12138abcd/stm32-gamepad/docs/porting-report.md

# STM32 / GD32 双平台兼容性验证报告

> **目的**：验证**同一份手柄固件源码**在 STM32F103C8T6 与 GD32F103C8T6 上的可移植性与行为一致性。
> **状态**：🟡 进行中（2026-10-07 开始）
> **背景**：研电赛赛题六硬性要求「使用兆易创新 GD32 MCU 芯片作为主控」；本项目原平台为 STM32F103C8T6。本报告即"**国产 MCU 平台兼容性替代验证**"的实证部分。

---

## 0. 摘要

* **一句话结论**：**同一份源码（仅新增一行）即可在 GD32F103C8T6 上正常运行，功能与性能在两平台上一致** —— 延迟差异落在一个直方图桶宽（10 µs）之内，ADC 差异落在静置噪声（3~7 counts）之内。
* **源码改动量**：**1 行**（新增 `HAL_ADCEx_Calibration_Start`，两平台共用）；**未引入任何平台宏或条件编译**
* **最关键的差异**：
  1. **烧写链路**：ST-Link 报 `Error: Not a genuine ST Device`，但不影响擦除/编程/校验（工具链现象，非功能差异）；
  2. **发现并修复了一个真实缺陷**：原固件从未调用 ADC 自校准 → 两平台静置中心相差最多 **104 counts**；补上校准后两平台对齐。
* **是否影响性能指标（P50/P95/P99）**：**不影响** —— STM32 0.52 / 0.97 / 1.02 ms vs GD32 0.53 / 0.98 / 1.01 ms；**`min` 两平台完全相同（26 µs）**；P99 仍 ≈ 1 ms（一个扫描节拍）。
* **能否共用一套标定参数**：**能** —— 加校准后两平台 ADC 读数差异 ≤ 4 counts（噪声级），标定常量取两平台平均即可。
* **待完成**：运行稳定性（`tx_*` 计数器、长时间运行）、结论章节。

---

## 1. 试验条件（控制变量）

| 项 | STM32 平台 | GD32 平台 |
| --- | --- | --- |
| MCU | STM32F103C8T6 | GD32F103C8T6 |
| 开发板 | 最小系统板（"蓝板"） | 最小系统板（"蓝板"） |
| 外部晶振 | 8 MHz | 8 MHz（✅ 已确认 / ⬜ 待确认） |
| 主频配置 | HSE ×9 = 72 MHz，USB 预分频 /1.5 = 48 MHz | 同 |
| 工具链 | Keil MDK 5.38 + ARMCLANG (AC6) | **同一个工程** |
| **源码** | git commit `<待填>` | **同一份，零改动** |
| 外设接线 | 8 按键 + 双摇杆 + SW1/SW2 | 同（Pin-to-Pin 兼容） |
| 供电 | USB 5V → 板载 LDO 3.3V | 同 |

> **公平性说明**：两平台使用**完全相同的源码、接线、测量方法、按键次数**，唯一变量是主控芯片。

---

## 2. 烧写与调试链路

| 项 | 结果 |
| --- | --- |
| 下载器 | ST-Link V2（驱动 6.1.2.0） |
| 目标连接 | ✅ 可连接（SWD） |
| **现象** | `Error: Not a genuine ST Device! Abort connection.` |
| 实际结果 | `Erase Done` → `Programming Done` → **`Verify OK`** → `Flash Load finished` |
| **判定** | ✅ **烧写成功**。该报错是 ST-Link 固件的"正版 ST 芯片"检测（GD32 自然不是 ST），**不阻断**后续操作 —— Keil 的 Flash 算法通过 SWD 直接操作目标 Flash 控制器，不依赖该认证 |
| 处理 | **忽略**。⛔ 不建议为消除它而降级 ST-Link 固件（旧版 6.1.1.0 会导致 µVision 崩溃，见 ARM KA005381） |
| 附带意义 | 该报错**反证目标确为 GD32**，可作为移植证据 |

---

## 3. 功能对照（✅ 已完成）

| # | 验证项 | STM32 | GD32 | 一致 |
| :---: | --- | :---: | :---: | :---: |
| 1 | USB 枚举（`VID_0483&PID_5750`，无黄色感叹号） | ✅ | ✅ | ✅ |
| 2 | `joy.cpl`：16 按钮 + 6 轴（X/Y/Rx/Ry/Z/Rz）+ POV | ✅ | ✅ | ✅ |
| 3 | 8 个按键（十字键 + A/B/X/Y） | ✅ | ✅ | ✅ |
| 4 | SW1 → L3、SW2 → R3 | ✅ | ✅ | ✅ |
| 5 | 左摇杆跟手 | ✅ | ✅ | ✅ |
| 6 | 右摇杆跟手（Rx/Ry） | ✅ | ✅ | ✅ |

**小结**：**零改动直烧即可正常运行**，直观效果无差别。这同时排除了三个大风险：

* **HSE 起振** —— 起不来会卡在 `SystemClock_Config()` 的 `Error_Handler()`
* **USB 48 MHz 时钟精度** —— 不准则枚举失败
* **Flash 等待周期** —— 配错通常跑飞或不稳

---

## 4. 量化对照（🟡 进行中）

> **为什么必须做这一步**：功能正常 ≠ 性能一致。延迟、ADC 行为这些**看不出来**的东西，恰恰是平台差异最容易藏身的地方。

### 4.1 端到端输入延迟

测量方法：固件内 `DWT->CYCCNT`（72 MHz，13.9 ns 分辨率）计时 + 10 µs 分桶直方图，统计量由 `latency_probe.c` 输出。
定义：**按键原始电平首次变化 → 该帧报告真正发上 USB 总线**；**只统计"按下"**；各按 A 键 100 次。

| 指标 | STM32 | GD32 | 目标 | 结论 |
| --- | :---: | :---: | :---: | :---: |
| P50 | **0.52 ms** | **0.53 ms** | ≤ 5 ms | ✅ 余量 ~89% |
| P95 | **0.97 ms** | **0.98 ms** | ≤ 10 ms | ✅ 余量 ~90% |
| P99 | **1.02 ms** | **1.01 ms** | ≤ 15 ms | ✅ 余量 ~93% |
| **min** | **26 µs** | **26 µs** | — | ✅ **完全相同** |
| max | ⬜（未单独记录） | **1019 µs** | — | |
| 样本数 / 超量程 / 误触发 | 100 / 0 / 0 | **100 / 0 / 0** | 100 / 0 | ✅ |

> **📊 读法（这段才是结论，不是数字本身）**
>
> 1. **`min` 两平台完全相同（26 µs）** —— 最有说服力的一项。`min` 代表**最短路径**（电平变化后当拍即发出），它一致说明"**GPIO 读取 → 报告上总线**"这条代码路径的耗时在两平台上一致。
> 2. **P50/P95/P99 的差异 ≤ 10 µs，而 10 µs 正好等于直方图桶宽** —— 差异落在**测量分辨率极限之内**，实质上即"**测不出差别**"（分位数取桶上边界 `(i+1)×10`，差一个桶属正常）。
> 3. **P99 ≈ 1 ms**（正好一个 1 ms 扫描节拍）在两平台都成立 → **"最坏情况 = 多等一拍、延迟由架构而非平台决定"这一结论跨平台成立** ✅
> 4. **`SystemCoreClock = 72 000 000`** → 顺带确认**时钟树配置两平台一致**，也支撑延迟探针"72 MHz / 13.9 ns 分辨率"的假设。
> 5. 链路自检正常：`probe_fall = 276`（打点脚翻转次数）、`probe_hist[13] = 2`、`probe_hist[100] = 2`（分布集中在低延迟区，无异常堆积）。

### 4.2 ADC 行为（摇杆）

> **⚠️ 本节实验过程中发现并修复了一个真实缺陷：原固件从未调用 ADC 自校准。**
> `MX_ADC1_Init()` 与 `main()` 的 `USER CODE 2` 中都没有 `HAL_ADCEx_Calibration_Start(&hadc1)`。
> F1 的 ADC 自校准用于消除内部电容失配引入的**偏移**与**增益**误差；不校准时偏移可达几十 LSB，且**每颗芯片各不相同**。

**① 加校准前（两平台同一份代码，仅此一项未做）**

| 项 | STM32 | GD32 | 说明 |
| --- | :---: | :---: | --- |
| 静置中心（左X/左Y/右Rx/右Ry） | 2001 / 2000 / 1984 / 2019 | 2060 / 2060 / 2060 / 2088 | 两平台差 **+59 ~ +104** |
| 推到最右 / 最下 | 4033 / 4030 | 4095 / 4095 | 满量程也差 **+62** |
| 推到最左 / 最上 | 0 | 1 | **低端无偏移** → 属**偏移/增益类**误差，不是器件公差 |

**② 加校准后（仅增加一行 `HAL_ADCEx_Calibration_Start`，两平台同一份代码）**

| 项 | STM32 | GD32 | 一致 |
| --- | :---: | :---: | :---: |
| 左摇杆静置 X / Y | 2057~2061 / 2057~2061 | 2060~2065 / 2057~2061 | ✅ 差异 ≤ 4（噪声内） |
| 右摇杆静置 Rx / Ry | 2050~2054 / 2081~2084 | 2050~2054 / 2081~2088 | ✅ 差异 ≤ 4（噪声内） |
| 静置噪声峰峰 | 4 / 4 / 4 / 3 counts | 5 / 4 / 4 / 7 counts | ✅ 同量级，均很小 |
| 推到最左 / 最上 | 0~2 | 0~2 | ✅ |
| 推到最右 / 最下 | **4095** | **4095** | ✅ |

> **结论**
>
> 1. 两平台 ADC 行为在**加校准后一致** —— 差异落在那 3~7 counts 的噪声范围内。
> 2. **标定常量可统一，无需平台分支** ✅（这正是本报告要回答的核心问题之一）
> 3. 加校准前观察到的差异**不是平台差异**，而是"**未校准偏移**"的**芯片个体差异**（这颗 STM32 偏约 −60，这颗 GD32 恰好接近 0）。
> 4. 附带收益：STM32 侧满量程由 `4033` 回到 `4095`，说明**增益误差也被校准一并修正**；静置噪声峰峰也从 14 counts 降到 4 counts。
> 5. **标定常量必须随之重测**（本次已重测并更新固件）—— 因为校准改变了原始读数的基准。

### 4.3 运行稳定性

| 项 | STM32 | GD32 |
| --- | :---: | :---: |
| `tx_ok`（累计成功帧数） | 0（第 3 步短时测试） | **133 601**（持续自增，≈1000 帧/秒） |
| **`tx_fail`** | 0 | **0** ✅ |
| **`tx_dropped`** | 0（第 3 步短时测试） | **976**（占比 **0.73%**）✅ 正常 |
| 本次上电运行时长（推算） | — | **≈134 秒** |
| 消抖 1 拍误触发 | 0 | ⬜ |

> **为什么 `tx_dropped ≠ 0` 仍属正常**
> 设备与主机是**两个独立时钟**（设备侧 72 MHz 晶振，主机侧自有时间基准）。在"1 ms 节拍发送 + 1 ms 轮询取走"的配置下，两者必然存在相位漂移：当"设备要发"与"主机来取"靠得太近时，新一代帧到达而上一帧尚未被取走，`USBD_CUSTOM_HID_SendReport` 返回 `USBD_BUSY`，该帧被丢弃。
> **这是该配置下固有的**（降至 0 不可能），且 HID 是**状态上报**模型 —— 丢一帧不影响正确性，下一帧携带的是最新状态。
>
> **量化判据**：丢帧率 **0.73%**（976 / 134 577）远低于端点参数退化时的量级（`bInterval = 5` 时约 **80%**，即 `tx_dropped` 每秒涨 ~800）→ **证明主机确实按 1 ms 取报告，端点参数未退化** ✅
>
> **⭐ 与延迟数据的互证（本报告的一个交叉验证）**
> `tx_dropped` 的存在**正是 P99 ≈ 1 ms 的物理来源** —— 被丢弃的那一帧，对应的输入事件要多等一个扫描节拍。
> 实测丢帧率 **0.73%**，而延迟直方图中 `probe_hist[100]`（1000~1010 µs 档）占 **2/100 = 2%** —— **两条独立数据同量级，互相印证**。

---

## 5. 差异清单与处理方式

| # | 差异项 | 现象 | 处理方式 | 是否需要平台宏 |
| :---: | --- | --- | --- | :---: |
| 1 | ST-Link 正版检测 | `Error: Not a genuine ST Device! Abort connection.` | **忽略** —— `Erase/Programming/Verify` 全部通过，不影响烧写与校验 | ❌ |
| 2 | **ADC 未校准**（真实缺陷，两平台都受影响） | 两平台静置中心差 +59~+104、满量程差 +62（低端均无偏移） | 增加 `HAL_ADCEx_Calibration_Start(&hadc1)`（一行，置于 `USER CODE 2` 内、`Start_DMA` 之前）→ **两平台对齐，差异降至噪声级** | ❌ |
| 3 | Flash 等待周期 | 未观察到异常（功能与延迟均正常） | 暂不处理 | ❌ |
| 4 | HSE 起振时间 | 未观察到异常（未卡在 `Error_Handler`） | 暂不处理 | ❌ |
| 5 | 延迟特性 | 差异 ≤ 10 µs（= 直方图桶宽），`min` 两平台完全相同 | 无需处理 | ❌ |
| 6 | 运行稳定性（`tx_*`） | ⬜ 待测 | ⬜ | ⬜ |

> 具体差异项以 **GD32F103xx 数据手册**与**《GD32F103xx 软件移植指南 AN001》**（兆易官方）为准，本表只记录**实测到**的差异。

---

## 6. 结论

* **源码可直接复用性**：✅ **完全可复用**。从 STM32F103C8T6 迁移到 GD32F103C8T6，**仅需新增一行 ADC 自校准调用**，无需任何平台宏、条件编译或代码分支。
* **是否需要平台分支 / 平台宏**：❌ **不需要**。加校准后两平台 ADC 读数差异 ≤ 4 counts（噪声级）、延迟差异 ≤ 10 µs（一个直方图桶宽）→ **同一份固件、同一套标定参数在两块板上通用**。
* **性能指标是否受影响**：❌ **不受影响**。P50/P95/P99 = **0.53 / 0.98 / 1.01 ms**（STM32 为 0.52 / 0.97 / 1.02 ms），**`min` 完全相同（26 µs）**，P99 仍 ≈ 1 ms（一个扫描节拍）→ **"延迟由 1 ms 节拍架构决定、与平台无关"这一结论跨平台成立**。
* **本次验证的额外收益**：
  1. 发现并修复了"**从未调用 ADC 自校准**"这一**独立于平台**的缺陷（两平台都受益：满量程回到 4095、静置噪声由 14 降至 4 counts）；
  2. 建立了三条可复用的验证判据：① `min` 值跨平台比对；② 延迟差异与直方图桶宽比较；③ **`tx_dropped` 占比作为"端点参数退化"的运行期探测器**。
* **遗留风险与后续验证项**：
  1. **长时间（≥ 72 h）运行稳定性**尚未验证（当前仅验证到 ≈134 秒量级）；
  2. **无线（2.4G）通路**未纳入本次验证范围；
  3. GD32F103 支持的最高主频 **108 MHz 未启用** —— 因 USB 需精确 48 MHz，继续以 72 MHz 运行为稳。
* **一句话总结**：**该固件具备"国产 MCU 平台兼容性替代"能力 —— 迁移成本一行代码，功能与性能无退化。**

---

## 附录

* **测试源码**：本仓库（同一 commit，零改动）
* **测量模块**：`Core/Src/latency_probe.c`（可用 `LATENCY_PROBE_ENABLE` 开关；关闭时完全不编译）
* **原始数据**：见项目内部存档（延迟直方图、ADC 原始值记录）
* **参考文档**：GD32F103xx 数据手册、《GD32F103xx 软件移植指南 AN001》
