12138abcd/stm32-gamepad/docs/board-soldered.jpg

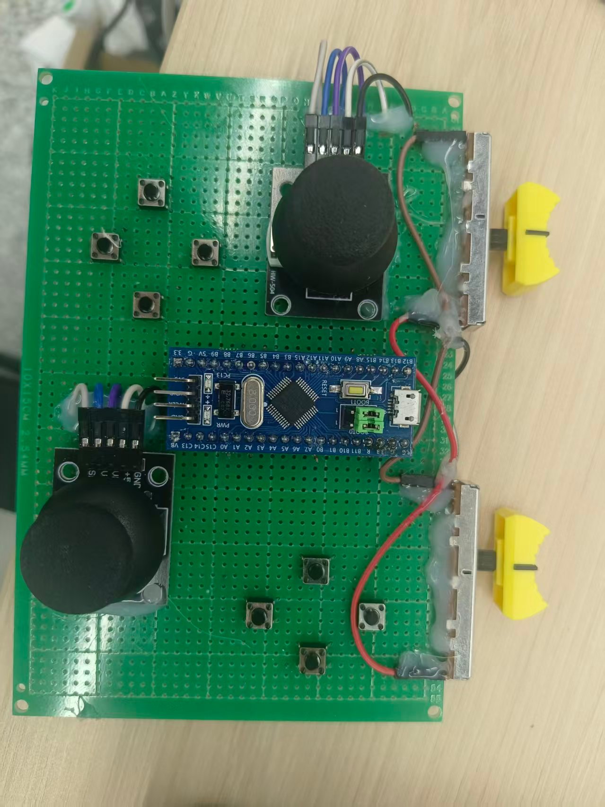
docs/board-soldered.jpg
