12138abcd/stm32-gamepad/Core/Src/main.c

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
/* Includes ------------------------------------------------------------------*/
#include "main.h"
#include "cmsis_os.h"
#include "usb_device.h"

/* USER CODE BEGIN Includes */
/* ↓ 原生 FreeRTOS API（vTaskDelayUntil / TickType_t / pdMS_TO_TICKS）。
          ⚠️ 必须放在 USER CODE 区内：CubeMX 重新生成代码不会丢。 */

#include "FreeRTOS.h"
#include "task.h"
#include "button_front.h"
#include "analog_input.h"
#include "report.h"
#include "latency_probe.h"   /* 可选的延迟测量模块；总开关在它的头文件里 */

#include "nrf24_test.h"
#include "p2p.h"             /* 无线第 4 步：两块板点对点测试 */
#include "proto_test.h"      /* 无线第 5 步：协议测试（帧格式 + 断线判据） */

#include "app.h"             /* 无线第 6 步：应用层总入口
                                ⚠️ 角色开关 DEVICE_ROLE 在 app.h 里（不在这里定义！） */

#include "wdt.h"             /* 第 10 步：双层看门狗（IWDG + WWDG） */

/* ================== 运行模式（四选一，从上到下优先）==================
   APP_MODE = 1        → 第 6 步：应用层（手柄发 / dongle 收 → USB）
   PROTO_TEST_MODE = 1 → 第 5 步：协议测试（proto_test.c）
   P2P_TEST_MODE = 1   → 第 4 步：点对点测试（p2p.c）
   三个都是 0          → 第 3 步：驱动自检（nrf24_test.c）
   ⚠️ 互斥！同时置 1 时按上面顺序取第一个。 */
#define APP_MODE        1
#define PROTO_TEST_MODE 0
#define P2P_TEST_MODE   0
/* USER CODE END Includes */

ADC_HandleTypeDef hadc1;
DMA_HandleTypeDef hdma_adc1;

SPI_HandleTypeDef hspi1;

/* Definitions for defaultTask */
osThreadId_t defaultTaskHandle;
const osThreadAttr_t defaultTask_attributes = {
  .name = "defaultTask",
  .stack_size = 256 * 4,
  .priority = (osPriority_t) osPriorityNormal,
};
/* USER CODE BEGIN PV */
uint16_t adc_buf[6];      /* [0] = PA0 = VRx, [1] = PA1 = VRy */
/* USER CODE END PV */

void SystemClock_Config(void);
static void MX_GPIO_Init(void);
static void MX_DMA_Init(void);
static void MX_ADC1_Init(void);
static void MX_SPI1_Init(void);
void StartDefaultTask(void *argument);

/**
  * @brief  The application entry point.
  * @retval int
  */
int main(void)
{
  /* MCU Configuration--------------------------------------------------------*/

  /* Reset of all peripherals, Initializes the Flash interface and the Systick. */
  HAL_Init();

  /* Configure the system clock */
  SystemClock_Config();

  /* USER CODE BEGIN SysInit */

  /* 第 10 步：双层看门狗第 1 层（IWDG 1s）。
     放在外设初始化之前 —— 初始化里任何一步卡死，1s 后都会被复位。
     代价：从这一行起 1s 内必须开始喂狗（1ms 任务启动后会喂）。
     复位原因（IWDG / WWDG / POR / 引脚）在这一行被读走并记进 BKP。 */
  wdt_init();

  /* USER CODE END SysInit */

  /* Initialize all configured peripherals */
  MX_GPIO_Init();
  MX_DMA_Init();
  MX_ADC1_Init();
  MX_SPI1_Init();
  /* USER CODE BEGIN 2 */
		/* ADC 自校准：消除内部电容失配造成的偏移误差。
	   必须在 HAL_ADC_Start / Start_DMA 之前调用一次。
	   不校准时，不同芯片的偏移能差几十 LSB —— 这正是 STM32 与 GD32 上
	   静置中心对不上的原因（1984~2019 vs 2060~2088）。 */
	if (HAL_ADCEx_Calibration_Start(&hadc1) != HAL_OK)
	{
		Error_Handler();
	}
	
	HAL_ADC_Start_DMA(&hadc1, (uint32_t *)adc_buf, 6);

	/* 打开延迟测量装置（打点脚 PB10 + DWT 周期计数器）。
	   整套实现在 latency_probe.c 里，总开关在它的头文件；
	   关掉开关时这一行会退化成空操作，一行机器码都不占。 */
	LatencyProbe_Init();
#if APP_MODE
	app_init();          /* 第 6 步：应用层（手柄建无线任务 / dongle 进接收模式） */
#elif PROTO_TEST_MODE
	proto_test_init();   /* 第 5 步：协议测试 */
#elif P2P_TEST_MODE
	p2p_init();          /* 第 4 步：点对点测试 */
#else
	nrf24_test_init();   /* 第 3 步：驱动自检（配 SPI1 + CSN/CE） */
#endif
  /* USER CODE END 2 */

  /* Init scheduler */
  osKernelInitialize();

  /* USER CODE BEGIN RTOS_MUTEX */
  /* add mutexes, ... */
  /* USER CODE END RTOS_MUTEX */

  /* USER CODE BEGIN RTOS_SEMAPHORES */
  /* add semaphores, ... */
  /* USER CODE END RTOS_SEMAPHORES */

  /* USER CODE BEGIN RTOS_TIMERS */
  /* start timers, add new ones, ... */
  /* USER CODE END RTOS_TIMERS */

  /* USER CODE BEGIN RTOS_QUEUES */
  /* add queues, ... */
  /* USER CODE END RTOS_QUEUES */

  /* Create the thread(s) */
  /* creation of defaultTask */
  defaultTaskHandle = osThreadNew(StartDefaultTask, NULL, &defaultTask_attributes);

  /* USER CODE BEGIN RTOS_THREADS */
  /* add threads, ... */
  /* USER CODE END RTOS_THREADS */

  /* USER CODE BEGIN RTOS_EVENTS */
  /* add events, ... */
  /* USER CODE END RTOS_EVENTS */

  /* Start scheduler */
  osKernelStart();

  /* We should never get here as control is now taken by the scheduler */
  /* Infinite loop */
  /* USER CODE BEGIN WHILE */
  while (1)
  {
    /* USER CODE END WHILE */

    /* USER CODE BEGIN 3 */
  }
  /* USER CODE END 3 */
}

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
/* USER CODE BEGIN Header_StartDefaultTask */
/**
  * @brief  Function implementing the defaultTask thread.
  * @param  argument: Not used
  * @retval None
  */
/* USER CODE END Header_StartDefaultTask */
void StartDefaultTask(void *argument)
{
  /* init code for USB_DEVICE */
  MX_USB_DEVICE_Init();
  /* USER CODE BEGIN 5 */
  /* 第 10 步：WWDG 必须在 USB 初始化【之后】开 ——
     MX_USB_DEVICE_Init 可能花几十 ms，早开会被 58ms 超时误复位。 */
  wdt_wwdg_start();
  wdt_task_arm(WDT_TASK_INPUT);   /* 本任务已进入主循环，开始参与心跳检查 */
  /* 1ms 周期任务：原来 main() 主循环里的四件事搬到这里。
        ⚠️ 必须用 vTaskDelayUntil（绝对周期），不能用 vTaskDelay / osDelay（相对延迟）——
              后者会把本任务的执行时间累积成周期抖动，直接毁掉延迟指标。
        四件事的顺序不能变：扫描 → 映射 → 打点 → 上报。 */
  TickType_t last = xTaskGetTickCount();
  for(;;)
  {
#if APP_MODE
    /* 第 6 步：应用层自己按角色做 —— 手柄 = 扫描+映射+USB+塞队列；dongle = 收包+USB
       ⚠️ 这里绝对不能再调 scan_buttons / analog_update / send_report！
          否则 dongle 端会用【悬空的按键和 ADC】覆盖无线收到的数据 —— 2026-10-21 踩坑：
          joy.cpl 轴乱跳、gamepad_report[0] 永远 0，就是这么来的。 */
    app_tick();
#else
    scan_buttons();          /* read GPIOs and debounce                 */
    analog_update();         /* read ADC, fill X/Y axes                 */
    LatencyProbe_OnTick();   /* 延迟测量：输入有变化就打点 + 计时 */
    send_report();           /* skip this tick if the previous transfer */
  #if PROTO_TEST_MODE
    proto_test_poll();       /* 第 5 步：接收端轮询收包（发送端空操作） */
  #elif P2P_TEST_MODE
    p2p_poll();              /* 第 4 步：接收端轮询收包（发送端空操作） */
  #else
		nrf24_test_poll();        /* 第 3 步：100ms 读一次 nRF24 STATUS */
  #endif
#endif

    /* 第 10 步：1ms 循环末尾 —— 先报“本任务还活着”，
       再让监督逻辑检查其他任务的心跳、按条件喂 IWDG、按节拍喂 WWDG。
       ⚠️ 必须放在本轮活全干完之后：放开头等于没检查。 */
    wdt_heartbeat(WDT_TASK_INPUT);
    wdt_loop_hook();

    vTaskDelayUntil(&last, pdMS_TO_TICKS(1));
  }
  /* USER CODE END 5 */
}

 /**
  * @brief  Period elapsed callback in non blocking mode
  * @note   This function is called  when TIM4 interrupt took place, inside
  * HAL_TIM_IRQHandler(). It makes a direct call to HAL_IncTick() to increment
  * a global variable "uwTick" used as application time base.
  * @param  htim : TIM handle
  * @retval None
  */
void HAL_TIM_PeriodElapsedCallback(TIM_HandleTypeDef *htim)
{
  if (htim->Instance == TIM4) {
    HAL_IncTick();
  }
}

/**
  * @brief  This function is executed in case of error occurrence.
  * @retval None
  */
void Error_Handler(void)
{
  /* USER CODE BEGIN Error_Handler_Debug */
  /* User can add his own implementation to report the HAL error return state */
  __disable_irq();
  while (1)
  {
  }
  /* USER CODE END Error_Handler_Debug */
}

#ifdef  USE_FULL_ASSERT
/**
  * @brief  Reports the name of the source file and the source line number
  *         where the assert_param error has occurred.
  * @param  file: pointer to the source file name
  * @param  line: assert_param error line source number
  * @retval None
  */
void assert_failed(uint8_t *file, uint32_t line)
{
  /* USER CODE BEGIN 6 */
  /* User can add his own implementation to report the file name and line number,
     ex: printf("Wrong parameters value: file %s on line %d\r\n", file, line) */
  /* USER CODE END 6 */
}
#endif /* USE_FULL_ASSERT */

/************************ (C) COPYRIGHT STMicroelectronics *****END OF FILE****/
