12138abcd/stm32-gamepad/Core/Inc/main.h

#define VRx1_Pin GPIO_PIN_0
#define VRx1_GPIO_Port GPIOA
#define VRy1_Pin GPIO_PIN_1
#define VRy1_GPIO_Port GPIOA
#define VRx2_Pin GPIO_PIN_2
#define VRx2_GPIO_Port GPIOA
#define VRy2_Pin GPIO_PIN_3
#define VRy2_GPIO_Port GPIOA
#define CSN_Pin GPIO_PIN_4
#define CSN_GPIO_Port GPIOA
#define NRF_SCK_Pin GPIO_PIN_5
#define NRF_SCK_GPIO_Port GPIOA
#define NRF_MISO_Pin GPIO_PIN_6
#define NRF_MISO_GPIO_Port GPIOA
#define NRF_MOSI_Pin GPIO_PIN_7
#define NRF_MOSI_GPIO_Port GPIOA
#define RT_Pin GPIO_PIN_0
#define RT_GPIO_Port GPIOB
#define LT_Pin GPIO_PIN_1
#define LT_GPIO_Port GPIOB
#define up_Pin GPIO_PIN_12
#define up_GPIO_Port GPIOB
#define down_Pin GPIO_PIN_13
#define down_GPIO_Port GPIOB
#define left_Pin GPIO_PIN_14
#define left_GPIO_Port GPIOB
#define right_Pin GPIO_PIN_15
#define right_GPIO_Port GPIOB
#define SW2_Pin GPIO_PIN_8
#define SW2_GPIO_Port GPIOA
#define VIEW_Pin GPIO_PIN_9
#define VIEW_GPIO_Port GPIOA
#define MENU_Pin GPIO_PIN_10
#define MENU_GPIO_Port GPIOA
#define LB_Pin GPIO_PIN_15
#define LB_GPIO_Port GPIOA
#define CE_Pin GPIO_PIN_3
#define CE_GPIO_Port GPIOB
#define RB_Pin GPIO_PIN_4
#define RB_GPIO_Port GPIOB
#define A_Pin GPIO_PIN_5
#define A_GPIO_Port GPIOB
#define B_Pin GPIO_PIN_6
#define B_GPIO_Port GPIOB
#define X_Pin GPIO_PIN_7
#define X_GPIO_Port GPIOB
#define Y_Pin GPIO_PIN_8
#define Y_GPIO_Port GPIOB
#define SW1_Pin GPIO_PIN_9
#define SW1_GPIO_Port GPIOB
