12138abcd/stm32-gamepad/Core/Src/wireless_rx.c

/**
 * @file    wireless_rx.c
 * @brief   dongle 端接收：收包 -> 按帧类型分流 -> USB（第 6 / 7 步）
 *
 * 报告帧(0x01) -> 写 gamepad_report -> send_report()
 * 心跳帧(0x02) -> 只更新链路，不写报告、不碰 USB
 * 断线          -> 周期发空闲报告，防"卡键"
 *
 * @note 为什么断线要发空闲报告、心跳为什么要维护 seq、探针的两个打点为什么有先后
 *       —— 详见《固件代码导读》11-§11.7、12-§12.9。
 */

#include "wireless_rx.h"
#include "proto.h"
#include "nrf24.h"
#include "main.h"
#include "report.h"
#include "latency_probe.h"   /* 无线探针的起点 / 配对 */
#include "param_store.h"     /* 第 9 步：配对 ID 存 Flash */
#include "wdt.h"             /* 第 10 步：写 Flash 前后喂 WWDG */
#include "cmsis_os.h"
#include <string.h>

/* 断线期间每 100ms 补发一次空闲报告：只发一次可能撞上端点忙而被丢；
   周期重发是幂等的（每次都是"全松开"），不会有副作用。 */
#define RX_IDLE_PERIOD_MS   100u

/* 第 9 步：上电后 10 秒内允许被配对（覆盖旧 ID）。
   为什么需要窗口：dongle 没有按键，配错对象后没法手动重配 ——
   只能靠"重新上电 + 窗口内让手柄再发一次配对帧"。 */
#define RX_PAIR_WINDOW_MS   10000u

/* 空闲报告：按键全 0、Hat 中立(8)、四轴居中(0x80)、扳机松开(0) */
static const uint8_t idle_report[PROTO_REPORT_LEN] =
    { 0x00, 0x00, 0x08, 0x80, 0x80, 0x80, 0x80, 0x00, 0x00 };

volatile uint32_t wrx_ok        = 0u;
volatile uint32_t wrx_bad_type  = 0u;
volatile uint32_t wrx_bad_sum   = 0u;
volatile uint32_t wrx_bad_seq   = 0u;
volatile uint32_t wrx_last_seq  = 0u;
volatile uint32_t wrx_link_lost = 0u;
volatile uint8_t  wrx_link_up   = 0u;
volatile uint32_t wrx_usb_sent  = 0u;
volatile uint32_t wrx_heartbeat = 0u;
volatile uint32_t wrx_idle_sent = 0u;

/* 第 9 步：配对状态 */
volatile uint8_t  wrx_paired_id = 0u;   /* 已配对的 ID；0 = 未配对 / 学习模式 */
volatile uint32_t wrx_pair_ok   = 0u;   /* 配对成功次数 */
volatile uint32_t wrx_pair_rej  = 0u;   /* 因 ID 不匹配被丢弃的帧数 */
volatile uint32_t wrx_pair_drop = 0u;   /* 窗口外收到的配对帧数 */

static uint16_t rx_expect    = 0u;   /* 期望的下一个 seq */
static uint8_t  rx_started   = 0u;   /* 是否已收到第一帧 */
static uint8_t  idle_first   = 1u;   /* 1 = 本次断线还没发过（进来先立刻发一次） */
static uint32_t idle_last_ms = 0u;

/* 第 10 步：配对结果的“待落盘”缓存。
   Flash 擦页约 20~40ms，不能放在 1ms 任务里 —— 会撞 WWDG 的窗口/超时。
   配对帧只登记，真正写入交给 dongle 的 appTask（wireless_rx_flush_save）。 */
static pad_params_t     rx_pending_params;
static volatile uint8_t rx_pending_valid = 0u;

void wireless_rx_init(void)
{
    nrf24_init();
    nrf24_flush_rx();
    nrf24_set_mode_rx();          /* PRIM_RX=1 + CE 高 */
    proto_link_reset();

    /* 第 9 步：从 Flash 读"要接受哪个 ID"（0 = 还没配过，进入学习模式）*/
    wrx_paired_id = (uint8_t)(param_get()->dev_id & 0xFFu);
}

/* 第 10 步：真正把配对参数写进 Flash（只由 dongle 的 appTask 调用）。
   取走缓存和清标志放临界区，防止 1ms 任务在拷贝中途登记新的配对。 */
void wireless_rx_flush_save(void)
{
    pad_params_t p;
    uint32_t primask;

    if (rx_pending_valid == 0u) { return; }

    primask = __get_PRIMASK();
    __disable_irq();
    p = rx_pending_params;
    rx_pending_valid = 0u;
    __set_PRIMASK(primask);

    /* 第 10 步：Flash 擦除会 stall 整个 CPU 20~40ms。
       先喂满 WWDG（必要时等过窗口内侧），写完立刻补喂 —— 58ms 预算够。 */
    wdt_flash_begin();
    (void)param_set(&p);
    wdt_flash_end();
}

void wireless_rx_poll(void)
{
    uint8_t  frame[PROTO_FRAME_LEN];
    uint8_t  report[PROTO_REPORT_LEN];
    uint16_t seq;
    uint8_t  dev_id;
    uint8_t  st;
    uint32_t now;
    uint8_t  link_before;

    now = HAL_GetTick();

    /* 断线检测：每 1ms 都查（不是只在收到包时查，否则永远检测不到"断了"）*/
    link_before = proto_link_is_up();
    wrx_link_up = proto_link_on_timeout(now);
    if (link_before && !wrx_link_up)
    {
        wrx_link_lost++;
    }

    st = nrf24_get_status();
    if ((st & NRF24_STATUS_RX_DR) != 0u)
    {
        /* 探针起点：必须在 read_rx_payload 之前 —— 读 FIFO 要几百 µs，
           放后面会把读包时间算进"收包 -> USB"，把 dongle 段算大。 */
        LatencyProbe_OnRxPacket();

        nrf24_read_rx_payload(frame, PROTO_FRAME_LEN);
        nrf24_clear_irq(NRF24_STATUS_RX_DR);

        /* 校验（类型 + 校验和），按失败原因分类统计 */
        if (proto_verify(frame) == 0u)
        {
            if ((frame[11] != PROTO_TYPE_REPORT) &&
                (frame[11] != PROTO_TYPE_HEARTBEAT) &&
                (frame[11] != PROTO_TYPE_PAIR))
            {
                wrx_bad_type++;
            }
            else
            {
                wrx_bad_sum++;
            }
        }
        else if (frame[11] == PROTO_TYPE_HEARTBEAT)
        {
            /* 心跳帧：只更新链路与序号 —— 这一步就是"有线模式下 PC 上只有一个设备在动"的关键 */
            seq = (uint16_t)frame[9] | ((uint16_t)frame[10] << 8);
            if (rx_started && (seq != rx_expect))
            {
                wrx_bad_seq++;      /* 心跳也占 seq，同样要维护期望值 */
            }
            rx_expect  = (uint16_t)(seq + 1u);
            rx_started = 1u;

            wrx_heartbeat++;
            wrx_link_up = proto_link_on_ok(now);
        }
        else if (frame[11] == PROTO_TYPE_PAIR)
        {
            /* ---- 第 9 步：配对帧 ----
               接受条件：还没配过（学习模式），或在上电后的 10 秒窗口内（允许重配）。
               接受后存 Flash —— 之后只认这个 ID。 */
            seq = (uint16_t)frame[9] | ((uint16_t)frame[10] << 8);
            if (rx_started && (seq != rx_expect))
            {
                wrx_bad_seq++;
            }
            rx_expect  = (uint16_t)(seq + 1u);
            rx_started = 1u;

            dev_id = frame[12];

            if ((wrx_paired_id == 0u) || (now < RX_PAIR_WINDOW_MS))
            {
                if ((dev_id != 0u) && (dev_id != wrx_paired_id))
                {
                    pad_params_t p = *param_get();
                    uint32_t primask;

                    p.dev_id = (uint16_t)dev_id;

                    /* 第 10 步：只登记、不在这里擦 Flash ——
                       1ms 任务里擦页 20~40ms 会撞 WWDG。
                       真正写入由 appTask 调 wireless_rx_flush_save() 完成。 */
                    primask = __get_PRIMASK();
                    __disable_irq();
                    rx_pending_params = p;
                    rx_pending_valid  = 1u;
                    __set_PRIMASK(primask);

                    wrx_paired_id = dev_id;
                    wrx_pair_ok++;
                }
            }
            else
            {
                wrx_pair_drop++;               /* 窗口外的配对帧：不理 */
            }

            wrx_link_up = proto_link_on_ok(now);
        }
        else if (proto_unpack(frame, report, &seq, &dev_id) != 0u)
        {
            /* 报告帧：正常路径 */
            if (rx_started && (seq != rx_expect))
            {
                wrx_bad_seq++;
            }
            rx_expect  = (uint16_t)(seq + 1u);
            rx_started = 1u;

            /* ---- 第 9 步：只接受已配对的 ID ----
               0 = 学习模式（还没配过），全收；
               非 0 = 已配对，别人的包直接丢，也不更新链路（那不是我们的链路）。 */
            if ((wrx_paired_id != 0u) && (dev_id != wrx_paired_id))
            {
                wrx_pair_rej++;
            }
            else
            {
                /* 探针配对：必须在 send_report() 之前 —— 先开测量，DataIn 才会把 t2 收尾。
                   帧里带的是【上一帧】的 t1（见 proto.h 的 PROTO_T1_OFS）。 */
                LatencyProbe_OnRxFrame(seq,
                    (uint16_t)((uint16_t)frame[PROTO_T1_OFS] |
                               ((uint16_t)frame[PROTO_T1_OFS + 1u] << 8)));

                memcpy(gamepad_report, report, PROTO_REPORT_LEN);
                send_report();
                wrx_usb_sent++;

                wrx_ok++;
                wrx_last_seq = seq;
                wrx_link_up  = proto_link_on_ok(now);
            }
        }
        else
        {
            /* proto_verify 过、unpack 却失败：理论上到不了（unpack 只多判一次类型）*/
            wrx_bad_sum++;
        }
    }

    /* 断线 -> 发空闲报告，防卡键（等于替玩家松手）。
       断线那一刻若玩家正推着摇杆，不发这个，PC 上就会一直卡在那个方向。 */
    if (wrx_link_up)
    {
        idle_first = 1u;        /* 恢复后重置：下次断线立刻发一次 */
    }
    else if (idle_first || ((uint32_t)(now - idle_last_ms) >= RX_IDLE_PERIOD_MS))
    {
        idle_first   = 0u;
        idle_last_ms = now;
        memcpy(gamepad_report, idle_report, PROTO_REPORT_LEN);
        send_report();
        wrx_idle_sent++;
    }
}
