12138abcd/stm32-gamepad/(commit log)

2026-09-28 第 1 步完成：USB HID 枚举通过，16 按键 + 6 轴报告描述符
2026-10-02 重构：按键/报告模块移到 Core 目录，改名 button_front，补上头文件与空实现
2026-10-02 报告发送链路打通：send_report 可用，joy.cpl 确认 9 字节报告内容正确
2026-10-02 启用 scan_buttons，send_report 增加 USBD_BUSY 丢帧统计,接线调试完毕
2026-10-03 添加 README、实物照片、joy.cpl 截图与接线图；.gitignore 忽略 Keil 生成的 scvd
2026-10-05 阶段4：摇杆接入 ADC1（PA0/PA1 + DMA），SW1 接入 PB9；build_report 完成轴数据搬运
2026-10-05 阶段5：新增 joystick 模块（中心校准+行程拉伸+死区），report.c 只管报告缓冲区；build_report 移除
2026-10-06 修正 USB 端点包大小(2→9)与轮询间隔(5→1)；加入 DWT 延迟测量装置(PB10 打点 + 直方图分位数)；消抖阈值改为可在线调整
    [button_front.c, main.c, report.c]
2026-10-06 消抖参数经对照实验定稿为 1 拍（P50 520us / P95 970us）；README 补入延迟实测数据与目录结构
2026-10-06 新增可选的延迟测量模块 latency_probe（DWT 计时 + 直方图分位数），main.c 只留三行接入
2026-10-07 feat: ADC 扩到 6 通道 + 右摇杆实测标定 + SW2/R3 + USB 端点宏编译期断言
2026-10-09 fix: 补上 ADC 自校准（此前从未调用）；按校准后实测重测 12 个标定常量
    - 原固件从未调用 HAL_ADCEx_Calibration_Start，两平台静置中心相差最多 104 counts
    - 加校准后 STM32/GD32 读数对齐（差异 <=4 counts），满量程回到 4095
    - 按加校准后的实测数据重测左右摇杆共 12 个标定常量（两平台取平均，一套通用）
    - 位置：main.c 的 USER CODE BEGIN 2 内、Start_DMA 之前
    [joystick.c, main.c]
2026-10-09 docs: 新增 GD32 移植验证报告与国产 MCU 可替代性评估报告
    - porting-report.md：试验条件、功能/延迟/ADC/稳定性对照、差异清单与结论
    - replaceability-report.md：迁移成本量化、替代收益、风险与缓解、可复用的三条验证判据
    - 核心结论：迁移成本 1 行代码、0 平台宏；功能与性能一致，无退化
2026-10-11 feat: 扳机单向映射（byte7/8）+ 模块改名 joystick -> analog_input
    - 新增 trig_map()：直滑电位器 B10K 单极性映射（0=松开、255=到底）；
    实测两路端点：松开 0~10 / 0~5，按到底 4093~4095 / 4094~4095
    - analog_update() 新增 byte7 = Z（左扳机 PB0）、byte8 = Rz（右扳机 PB1）
    - 模块职责已从"摇杆"扩展为"模拟输入"（摇杆双极性 + 扳机单极性，规律相反），
    故 joystick.c/.h -> analog_input.c/.h，joystick_update -> analog_update；
    引用同步：main.c / latency_probe.c 注释 / report.c 注释 / PS.uvprojx / PS.uvoptx
    - 修复 CubeMX GENERATE CODE 的连带破坏：
    * 端点宏被冲回默认值（DESC_SIZE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
2026-10-13 feat: 迁移到 FreeRTOS（1ms 输入任务）+ 加固 CubeMX 重生成后的修复流程
    功能
    - main.c: StartDefaultTask 改造为 1ms 输入任务（vTaskDelayUntil 绝对周期，四件事顺序不变）；
    调度器启动；MX_USB_DEVICE_Init() 在任务内初始化；任务栈 1KB；
    原生头 FreeRTOS.h/task.h 放在 USER CODE 区（CubeMX 不覆盖）
    - FreeRTOSConfig.h: 补 CMSIS_device_header / INCLUDE_xTaskGetCurrentTaskHandle /
    INCLUDE_xSemaphoreGetMutexHolder / USE_CUSTOM_SYSTICK_HANDLER_IMPLEMENTATION
    （全部放在 USER CODE 区）
    修复 CubeMX GENERATE CODE 造成的破坏
    - FreeRTOS 端口 RVDS(AC5 专用) -> GCC 端口内容（否则 ARMCLANG 报 unknown type na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
2026-10-14 refactor: 删除 main.c 里裸机主循环的残留（FreeRTOS 迁移后的死代码）
    - osKernelStart() 永不返回，所以那段 while(1) 里的
    `if (HAL_GetTick() - last >= 1) { scan_buttons(); ... }` 永远走不到
    - 风险：它看起来像"固件还在轮询"，会让人误判 RTOS 没生效
    （用户本人就被它迷惑过，专门来核实）
    - 改为空的 while(1){} + 注释："这是调度器启动失败的兜底死循环；
    真正的 1ms 任务在 StartDefaultTask()，用 vTaskDelayUntil 定周期"
    - 同步更新 tools/_head/main.c（乱码还原用的参考原文）
    - 验证：armclang 编译 main.c exit=0；删的是永不可达代码，延迟指标不受影响
2026-10-16 feat: 无线 A 路线第 1~2 步 —— CubeMX 配 SPI1 + nRF24 SPI 验证通过（STATUS = 0x0E）
    CubeMX 配置（PS.ioc）
    - SPI1: Full-Duplex Master / 8bit / MSB First / CPOL Low + CPHA 1 Edge (Mode 0)
    / Prescaler 64 = 1.125 MBits/s / NSS Signal Type = Software
    引脚自动分配 PA5=SCK、PA6=MISO、PA7=MOSI
    - PA4 = GPIO_Output（Label CSN，初值 High）；PB3 = GPIO_Output（Label CE，初值 Low）
    （PB3 依赖 Serial Wire 生成的 __HAL_AFIO_REMAP_SWJ_NOJTAG；SWD 下载不受影响）
    - PA5/PA6/PA7 亦设 Label：NRF_SCK / NRF_MISO / NRF_MOSI
    - HAL_SPI_MODULE_ENABLED 由 CubeMX 自动启用
    新增（无线验证代码）
    - Core/Inc/nrf24_test.h + Core/Src/nrf2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
2026-10-16 chore: 停止跟踪 MDK-ARM/PS.uvoptx（Keil 个人调试状态）
    PS.uvoptx 里装的是断点、Watch 变量列表、窗口布局这类"每台机器都不一样"的东西，
    每加一个 Watch 变量它就变一次 —— 留在公开仓库里只有噪音，还容易在多人协作时互相覆盖。
    本次改动：
    - git rm --cached MDK-ARM/PS.uvoptx（本地文件原样保留，只是不再纳入版本控制）
    - .gitignore 增加 MDK-ARM/PS.uvoptx
    - 同时修正 .gitignore 末尾那段与实际做法矛盾的说明：
    它原文写着「PS.uvoptx —— 保留提交（调试器选型 ST-Link 在里面）」，
    而 _交接存档.md 里记的是「已知瑕疵：严格说不该进公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
2026-10-16 feat: nRF24 底层驱动 + 驱动自检（无线 A 路线第 3 步）
    【驱动】Core/Src/nrf24.c + Core/Inc/nrf24.h
    - 寄存器读写（含多字节地址）、FIFO 读写、收发模式切换、发一包并等结果
    - 直接用 CubeMX 生成的 hspi1 与 CSN(PA4)/CE(PB3)，不重复初始化 SPI/GPIO
    - DWT 微秒延时（CE 脉冲用）：自己使能，不依赖 latency_probe 的开关
    （产品版关掉延迟探针时，无线照样要能发）
    - CE 脉冲宽度做成变量 nrf24_ce_pulse_us，默认 200µs（> Tstby2a = 130µs）
    - 配置在 nrf24_init() 里一次写好：2 字节 CRC / 5 字节地址 /
    ARD 500µs + ARC 3 次重传 / 信道 76 / 1Mbps 0dBm / Pipe0 固定包长
    -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
2026-10-18 状态：第 1~5 步已完成并通过量化验收（端到端延迟 P50 0.52ms / P95 0.97ms / P99 1.02ms）；第 6 步进行中 —— 无线 A 路线已到第 4 步（两块板点对点，双向 0 误码 / 0 丢包）。
2026-10-18 feat: 无线 A 路线第 4 步 —— 两块板点对点收发验证（含 README 状态更新）
    【新增】Core/Src/p2p.c + Core/Inc/p2p.h
    - 同一份工程，改 P2P_IS_TX 宏编译出两个固件（1 = 发送端 / 0 = 接收端）
    - 发送端：独立任务（osThreadNew，优先级低于 defaultTask），每 10ms 发一包 32 字节
    载荷 = seq(2) + magic 0xA5 0x5A(2) + 模式(2) + 保留(4) + 校验和(2) + 补 0 到 32
    - 接收端：1ms 轮询 RX_DR，读 FIFO 后做三项校验（magic / 校验和 / seq 连续）
    - 统计量全部暴露到 Watch：tx_sent / tx_ok / tx_maxrt、rx_ok / rx_bad_data / rx_bad_seq
    - 载荷长度必须 = RX_PW_P0(32)：Enhanced ShockBurst 要求收发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
2026-10-18 docs: 更新实物照片（2026-10-18）并同步 README 的实物说明
    - docs/board-soldered.jpg：替换为当前实物照片
    （双摇杆 + 双扳机 + 8 个轻触开关 + 排针上的 nRF24L01，146 KB → 270 KB）
    - README.md 实物说明写得更具体：
    · 洞洞板 + 热熔胶固定，蓝板居中
    · 双扳机是「直滑电位器 + 黄色滑柄」（不是拨杆）
    · nRF24L01 插在左上排针上（SPI1 + CSN/CE）
    · SWD 四线接 ST-Link，并补了拍摄日期
    本次只动照片和门面文字，不涉及任何代码。
2026-10-19 状态：硬件补到 12 键（新增 LB/RB/View/Menu），无线 A 路线第 4 步已验证通过；下一步第 5 步「协议设计：帧格式 / 配对 / 断线判据」。
2026-10-19 feat: 补 4 个按键（LB/RB/View/Menu）+ 实物标注图
    【CubeMX 配置】4 个新引脚，全部 GPIO_Input + Pull-up
    - PA15 = LB，PB4 = RB（两个都是 JTAG 脚，靠 __HAL_AFIO_REMAP_SWJ_NOJTAG() 释放）
    - PA9 = View，PA10 = Menu（原本是 USART1_TX/RX，串口让位）
    - .ioc 已提交，main.h 自动生成 LB_Pin / RB_Pin / VIEW_Pin / MENU_Pin
    【代码】button_front.c
    - 新增 4 个 deb_t（db_lb / db_rb / db_view / db_menu）+ 两段扫描：
    LB/RB → 报告 byte0 的 bit4 / bit5
    View/Menu → 报告 byte0 的 bit6 / bit7
    - 新增 count_lb / count_rb 调试计数器（Watch 可看）
    - report.h 里的 BTN_LB / BTN_RB / BTN_VIEW / BTN_MENU 位定义本来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
2026-10-19 docs: 标注图压缩（1028.8 KB → 133.6 KB，质量 85）
    - docs/board-annotated.jpg：同一张用户标注图，用 JPEG 质量 85 重编码
    - 尺寸不变（1018x756），红框和文字清晰度可接受
    - README 首图加载更快，git 仓库也省 900 KB
2026-10-20 docs: 新增 6 小时长时实测报告 + README 补一节
    【新增】docs/soak-test-2026-10-19.md（6 小时长时实测报告）
    - 环境：STM32F103C8T6 + 12 键 + 双摇杆 + 双扳机，p2p 固件，USB HID，Windows 10
    - 方法：连续 6 小时操作，每 30 分钟抽检 joy.cpl，出问题立即记录
    - 结果：前 2 小时全部正常；后 4 小时 View 键响应变差 + RT 一次偶发异常
    - 排查：先怀疑硬件（View=PA9 / RT=PB0 无共用硬件）→ 分离变量 →
    关闭游戏进程的 DLL 注入器（winhttp.dll）→ View 恢复
    - 结论：View = 软件侧注入冲突（与手柄硬件/固件无关）；
    RT = 偶发未复现；手柄固件 6 小时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
2026-10-21 feat: 无线 A 路线第 5 步 —— 协议层（帧格式 + 断线判据）
    【新增】Core/Inc/proto.h + Core/Src/proto.c
    - 帧格式（32 字节，沿用 RX_PW_P0 = 32）：
    0-8 HID 报告 9 字节（原样，dongle 收到直接 memcpy 发 USB）
    9-10 序号 seq（uint16，每帧 +1）
    11 帧类型（0x01 = 报告帧）
    12 设备 ID（0 = 未配对，为第 6 步配对预留）
    13-14 校验和（对 0~12 累加，小端）
    15-31 补 0
    - proto_pack / proto_unpack / proto_checksum
    - 断线状态机：
    · dongle 侧：100ms 没收到合法包 → 断线（proto_link_on_timeout）
    · 手柄侧：连续 10 次 nrf24_send 返回 MAX_RT → 断线（pro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
2026-10-21 feat: 无线 A 路线第 6 步 —— 手柄端集成（app 总入口 + 无线收发模块）
    【新增】Core/Inc/app.h + Core/Src/app.c（应用层总入口）
    - DEVICE_ROLE 切角色：0 = 手柄（本地输入 + 无线发 + USB 发）/ 1 = dongle（无线收 + USB 发）
    - app_init()：按角色初始化（手柄建无线任务 / dongle 进接收模式）
    - app_tick()：1ms 调用 —— 手柄：scan → analog → probe → USB → 塞队列
    dongle：wireless_rx_poll（收包 → 写 gamepad_report → USB 发）
    【新增】Core/Inc/wireless_tx.h + Core/Src/wireless_tx.c（手柄端发送）
    - 队列（深度 2，CMSIS-RTOS2 osMessageQueue）+ 独立任务
    - 1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
2026-10-23 无线第 7 步双通道切换完成：拔插四次 dev_state 3↔4 / ch_mode 0↔1 全对，延迟 P50 500µs 无回归。
2026-10-23 fix: nRF24 初始化等 POR + USB 中断优先级降到 4
    两个"偶发、按一下复位就好"的隐蔽 bug，今天都用数据定位了。
    1) nRF24 初始化：下载后第一次连不上无线
    现象：下载完程序在跑，但无线不通；按一下 MCU 复位键就正常。
    根因：ST-Link 下载时的 Flash 编程电流把 3.3V 拉低，nRF24 跟着掉电；
    重新上电后它要 ~10ms 才响应 SPI，这段时间写的寄存器【全部被忽略且不报错】。
    第 6 步加的"软复位"也救不回来 —— 软复位本身就要用 SPI 去写寄存器。
    修法：nrf24_init() 开头 HAL_Delay(20)（NRF24_BOOT_POR_MS）等 POR；
    软复位后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
2026-10-23 feat: 无线 A 路线第 7 步 —— 双通道切换（有线 ↔ 无线）
    第 6 步结束时是"双发"：手柄发 USB、dongle 也在发 USB，PC 上两个 HID 设备同时动。
    这一步把它收成单发，并做到拔线不留空窗。
    核心设计：
    - 通道判据看【USB 侧】，不是无线侧：
    APP_CH_WIRED dev_state == CONFIGURED -> 走 USB；无线降频 20ms 发心跳
    APP_CH_WIRELESS 没 USB 但链路通 -> 无线满速发报告帧
    APP_CH_LOST 两条都不通 -> 仍满速发（不发就永远连不回来）
    去抖 5 拍（5ms）。
    为什么不能只用 proto_link_is_up()：它只回答"无线健不健康"，回答不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
2026-10-26 第 8 步无线延迟测量完成：手柄段 P50 770µs + dongle 段 790µs = 1.56ms（乐观估计），目标 5ms。
2026-10-26 feat: 无线 A 路线第 8 步 —— 无线延迟测量（两段相加）
    目标：无线模式也要 P50 <= 5ms（和有线的目标相同）。
    为什么不能像有线那样直接测：
    有线：一个探针、同一块板、同一个 DWT->CYCCNT，起点终点直接相减。
    无线：跨两块板，DWT->CYCCNT 各自从 0 开始，【没有共享时钟】，
    拿手柄的起点减 dongle 的终点毫无意义。
    所以拆成两段（同一块板内各自算差值，结果可以相加）：
    第一段（手柄）：按键原始电平变化 -> nrf24_send() 返回 TX_OK
    第二段（dongle）：发现 RX_DR -> USB DataIn 完成
    为什么第一段终点选 TX_OK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
2026-10-26 第 8 步无线延迟最终数据（严格配对）：端到端 P50 1.59ms / P95 2.60ms / P99 2.78ms，目标 5/10/15ms。
2026-10-26 feat: 第 8 步无线延迟 —— 严格配对（帧里带 t1，dongle 按 seq 配对）
    上一版（99753fa）用的是"两段相加"：手柄段 P50 + dongle 段 P50。
    那是个【乐观估计】，不能当报告数据 —— 因为分位数不可加：
    - 两段的"典型值"不会同时出现 -> P50 被低估
    - 两段的"最坏值"不会同时出现 -> P95/P99 被高估
    实测也证实了：A 给 P50 1350 / P95 3020 / P99 3410，而真实是 1590 / 2600 / 2780。
    这一版改成【严格配对】：同一个按键事件的两段，配上之后再统计。
    核心思路：传"持续时间"，不传"绝对时刻"
    t1（手柄段）= 输入变化 -> nrf24_send 返回 TX_OK，一个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
2026-10-26 代码整理完成：测试代码归档到 Core/Src/test/，9 个自研文件注释精简（净减 311 行），逻辑零变化。
2026-10-26 refactor: 测试代码归档到 Core/Src/test/
    nrf24_test.c / p2p.c / proto_test.c 从 Core/Src 移到 Core/Src/test/，
    让主目录只剩产品代码（9 个自研 .c）。
    为什么移动：
    这三个文件只在测试模式下参与（main.c 顶部的 PROTO_TEST_MODE / P2P_TEST_MODE，
    或三个宏全 0 时的驱动自检），平时不跑。放主目录容易让人误以为是产品逻辑。
    改动：
    - PS.uvprojx 里三条 FilePath 同步改成 ..\Core\Src\test\xxx.c（Keil 打开即可编译）
    - 头文件仍在 Core/Inc，include 路径不变
    - 三个文件的内容一行未改（git 识别为 rename，历史保留）
2026-10-26 refactor: 注释精简 —— 讲解型内容移到《固件代码导读》
    9 个自研 .c 的文件头和行内注释做了精简（净减 311 行），**逻辑零变化**：
    app.c 184 -> 141
    button_front.c 178 -> 143
    nrf24.c 307 -> 272
    analog_input.c 115 -> 80
    wireless_tx.c 158 -> 130
    report.c 61 -> 39
    proto.c 171 -> 156
    wireless_rx.c 165 -> 151
    latency_probe.c 667 -> 583（只改文件头：其余长注释是"为什么"，属于该留的）
    精简原则：
    - 文件头：@file / @brief（一句话）+ 一条 @note 指向导读的对应章节
    - 函数：@brief + 关键的 @param / @return
    - 行内：只说"为什么"和坑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
2026-10-28 Flash 参数存储 + 配对完成：首次上电 param_boot_status=1、复位后 0；配对 ID 存 Flash，手动改错 ID 后 wrx_pair_rej 涨到 4988 证明校验生效。
2026-10-28 feat: Flash 参数存储（双备份 + CRC32）+ 配对（dev_id）
    之前两个问题：
    1) 摇杆校准常量是代码里的宏 -> 换块板就要重测 12 个值、改代码、重编译、重烧
    2) 配对 ID 没地方存（dev_id 一直发 0，等于谁都能控制 dongle）
    == 一、Flash 参数存储（新文件 param_store.c/h）==
    分区（F103C8T6：64KB = 64 页 x 1KB）：
    页 0~61 程序
    页 62 参数 A 0x0800F800
    页 63 参数 B 0x0800FC00
    结构 40 字节（packed）：
    magic(4) + seq(4) + version(2) + dev_id(2) + 12 个校准常量(24) + crc32(4)
    读写策略：
    读：两页都验 CRC，取"有效且 seq 大"的那页
    写：擦【旧】页 -> 写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
2026-10-28 第 9 步收尾：状态文件已更新到 10-28，README 目录结构补全为 17+3 源文件，下一步双层看门狗。
2026-10-28 docs: README 目录结构补全 + 忽略 clangd 的 compile_commands.json
    背景：
    README 第九节「目录结构」还是老的 4 个文件，而且名字写错了
    （joystick.c 实际是 analog_input.c），跟现在的 20 个源文件对不上。
    1) README 第九节重写目录树
    - Core/Inc 17 个头文件、Core/Src 17 个源文件 + test/ 3 个测试文件
    - USB_DEVICE（App/Target）、Middlewares、Drivers、MDK-ARM、PS.ioc 各一句
    - ★ 标出 4 个最值得先看的：app.c / latency_probe.c / param_store.c / usbd_conf.c
    - 补一条 GENERATE 警告：PS.ioc 会重写生成文件，端点三件套（78/9/1）
    和 FreeRTOS 补丁会被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
2026-11-06 第 10 步双层看门狗代码完成：IWDG 1.5s + WWDG 58ms 窗口 + 任务心跳监督 + 复位原因存 BKP，手柄/dongle 双角色编译 0 错 0 警，待硬件验收。
2026-11-06 feat: 第 10 步双层看门狗（IWDG 1.5s + WWDG 58ms 窗口）+ 心跳监督 + 复位原因
    交付标准要求「死机自恢复」，之前没有任何看门狗。
    单看门狗不够：IWDG 只能抓「完全卡死」，抓不到「任务饿死但主循环还在跑」；
    WWDG 的窗口还能抓「喂早了 / 节拍丢了」。
    一、新增 wdt.c / wdt.h（寄存器直写，不用 HAL 的 IWDG/WWDG 模块）
    IWDG：LSI/32 = 1250Hz，RLR = 1875 → 1.5s（LSI 30~60kHz → 1.0~2.0s）
    只在【所有已武装任务心跳都新鲜】时喂；某任务卡死就停喂，1.5s 复位
    WWDG：PCLK1 36MHz，WDGTB=/8 → 0.9102ms/拍；超时 58.25ms，窗口 0x6F（14.5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
